fernd4wg/Analog-to-Digital-Converter/Images/wbs-chart.jpg

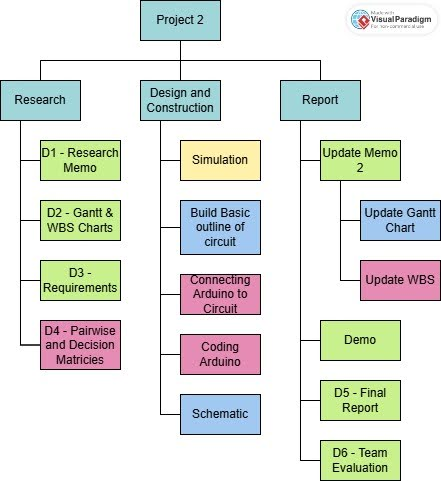
Images/wbs-chart.jpg
