fernd4wg/Analog-to-Digital-Converter/Images/circuit-schematic.jpg

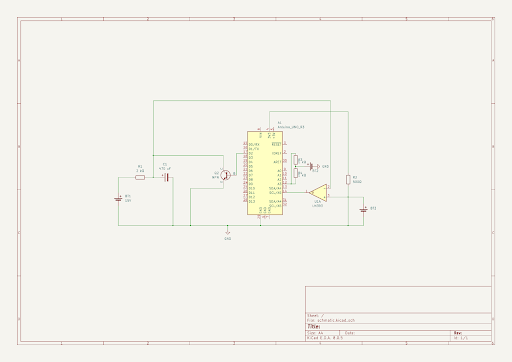
Images/circuit-schematic.jpg
