fernd4wg/Analog-to-Digital-Converter/Images/flow-chart.jpg

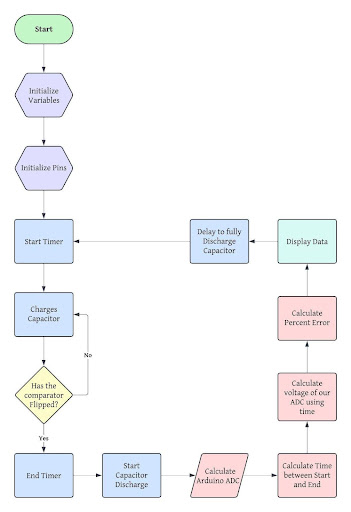
Images/flow-chart.jpg
