fernd4wg/Analog-to-Digital-Converter/Images/gantt-chart.jpg

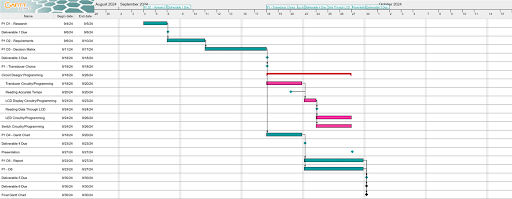
Images/gantt-chart.jpg
